vaxdatex/Modulator-DIY/MODPNL2_Montaza/MODPNL2-layout.pdf

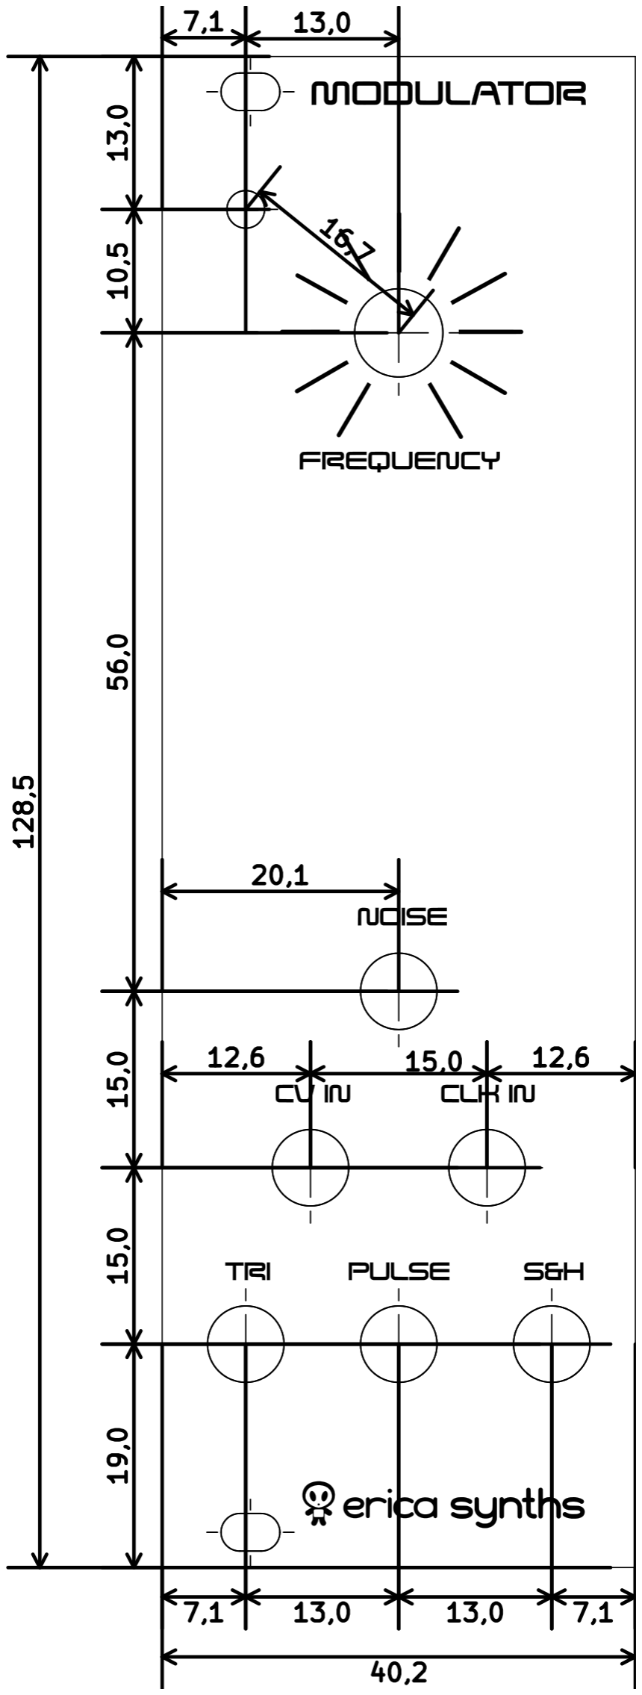
[picture p1: page 1]
