vaxdatex/Modulator-DIY/MODPNL2_Montaza/MODPNL2-layout_noDim.pdf

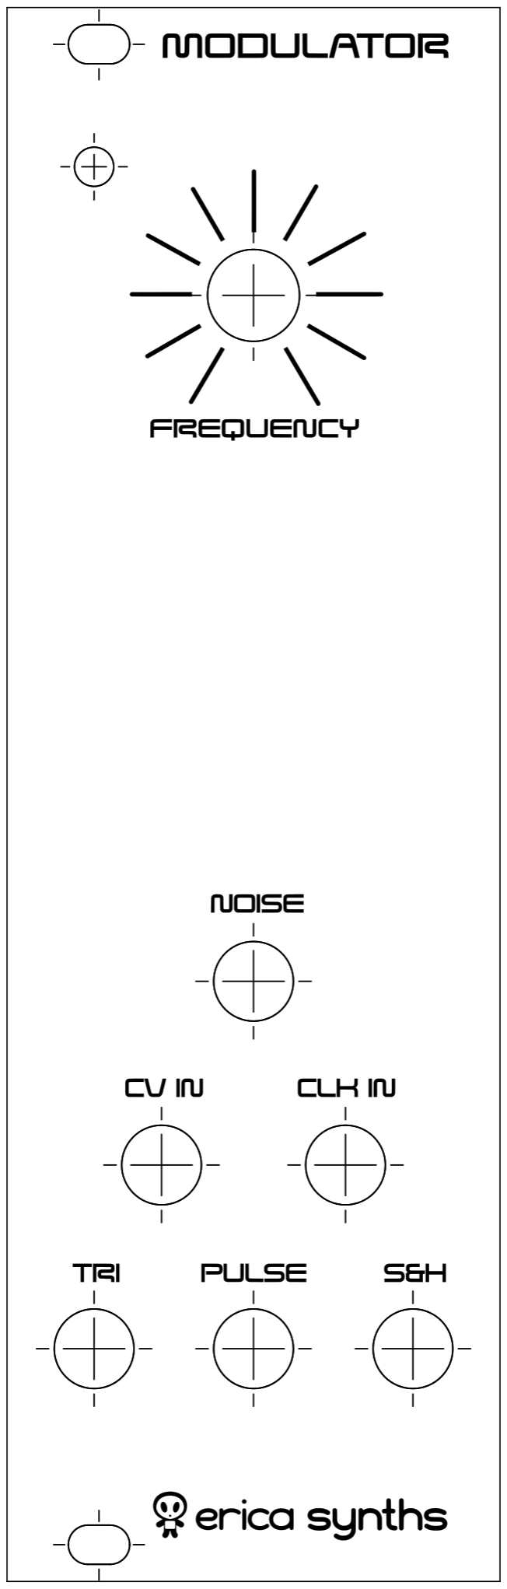
[picture p2: page 1]
