vaxdatex/Modulator-DIY/Zener Noise/DIY_Acid_Noise_v1_0_BOM.xls

Id | Designator | Package | Quantity | Designation | Supplier and ref
1 | R16,R19,R30,R32 | R_W4_THT | 4 | 100k
2 | C6,C7,C10,C11 | C-5mm | 4 | 0.1uF
3 | C14,C19 | CE63x25 | 2 | 47uFx16V
4 | L3,L4 | R0125W | 2 | OR
5 | R35 | RKT6V | 1 | 10k
6 | XP2,XP3 | PLS-4 | 2 | PLS-4
7 | C16,C21 | CE63x25 | 2 | 10uFx16V
8 | C23,C24,C25 | CE63x25_NP | 3 | 10uFx25V
9 | C26 | C-5mm | 1 | 22nF
10 | VD19 | DO-35 | 1 | 6.2V
11 | VD20,VD21,VD22,VD23 | DO-35 | 4 | 1N4148
12 | DA2 | DIP-14_Socket | 1 | TL074
13 | R12,R20,R49 | R_W4_THT | 3 | 10k
14 | R22,R23,R47 | R_W4_THT | 3 | 56k
15 | R26,R27,R46,R48 | R_W4_THT | 4 | 1k
16 | R42,R43 | R_W4_THT | 2 | 2.2k
17 | R44,R45 | R_W4_THT | 2 | 220k
