vaxdatex/Modulator-DIY/DIY_Modulator_Assembly/Noise/DIY_Polivoks_Modulator_Noise_v1_1_BOM.xls

Id | Designator | Package | Quantity | Designation | Supplier and ref
1 | C6,C7,C10,C11,C16,C19 | C-5mm | 6 | 0.1uF
2 | C14 | CE63x25 | 1 | 1uFx25V
3 | C18 | C-5mm | 1 | 10pF
4 | C21 | C-5mm | 1 | 22nF
5 | DA2 | DIP-8_Socket | 1 | TL072
6 | L3,L4 | R0125W | 2 | OR
7 | R12,R16,R23 | R_W4_THT | 3 | 470k
8 | R19,R22,R27 | R_W4_THT | 3 | 10k
9 | R20 | R_W4_THT | 1 | 2M
10 | R30 | R_W4_THT | 1 | 56k
11 | R32 | R_W4_THT | 1 | 220k
12 | R35 | RKT6V | 1 | 470k
13 | VT2 | TO-92-M | 1 | 2N3904
14 | XP2,XP3 | PLS-4 | 2 | PLS-4
