vaxdatex/Modulator-DIY/DIY_Modulator_Assembly/DIY_Polivoks_Modulator_v1_1.pdf

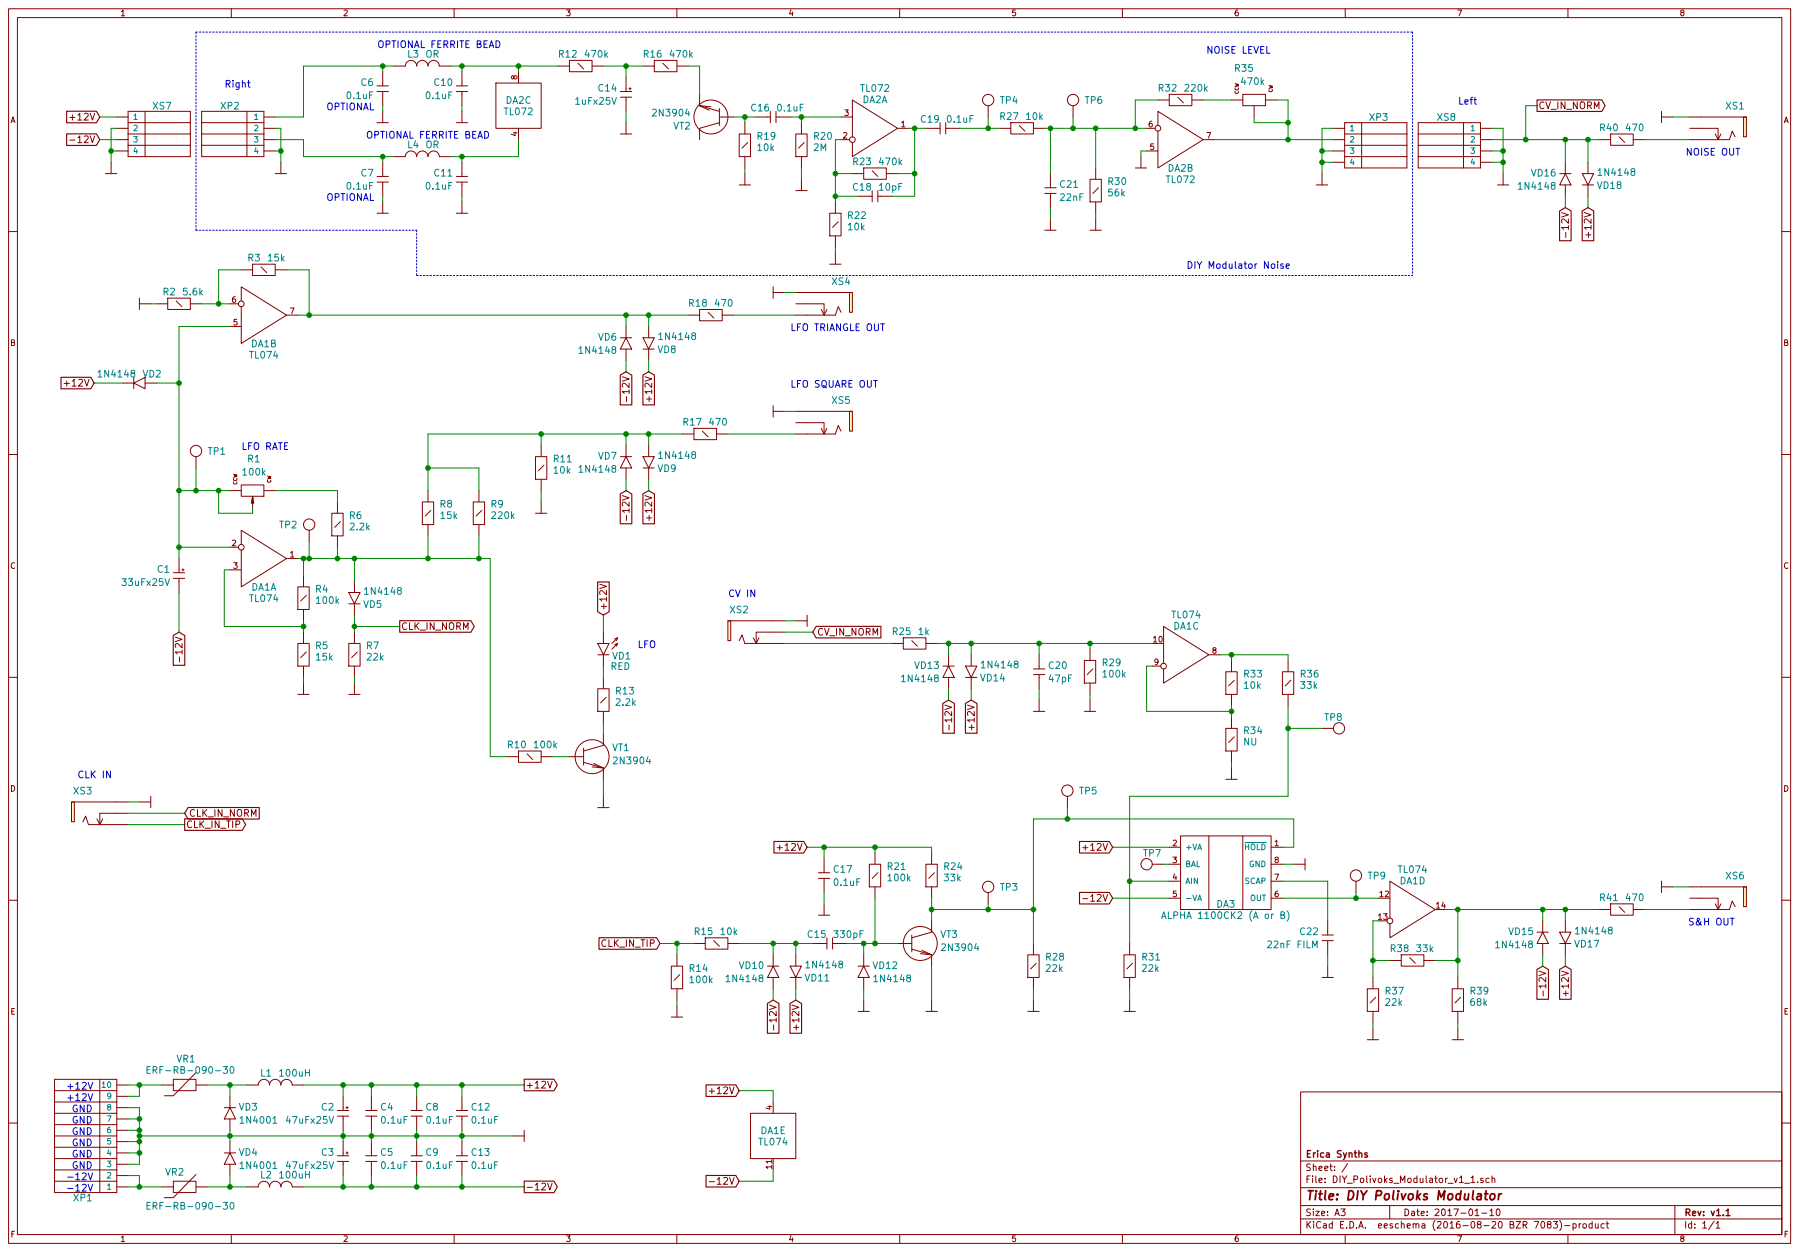
[picture p3: page 1]

VR1 ERF-RB-090-30 VR2 ERF-RB-090-30

GND | 10 XP1 +12V 7
+12V GND | 9

GND | 6
GND | 5
GND | 4

File: DIY_Polivoks_Modulator_v1_1.sch Sheet: / Erica Synths

-12V | 2
-12V | 1

Id: 1/1 Title: DIY Polivoks Modulator
